ntchaps/Mono-RTP-over-UDP-Transmitter/docs/Demos/Videos/IMG_7279.JPG

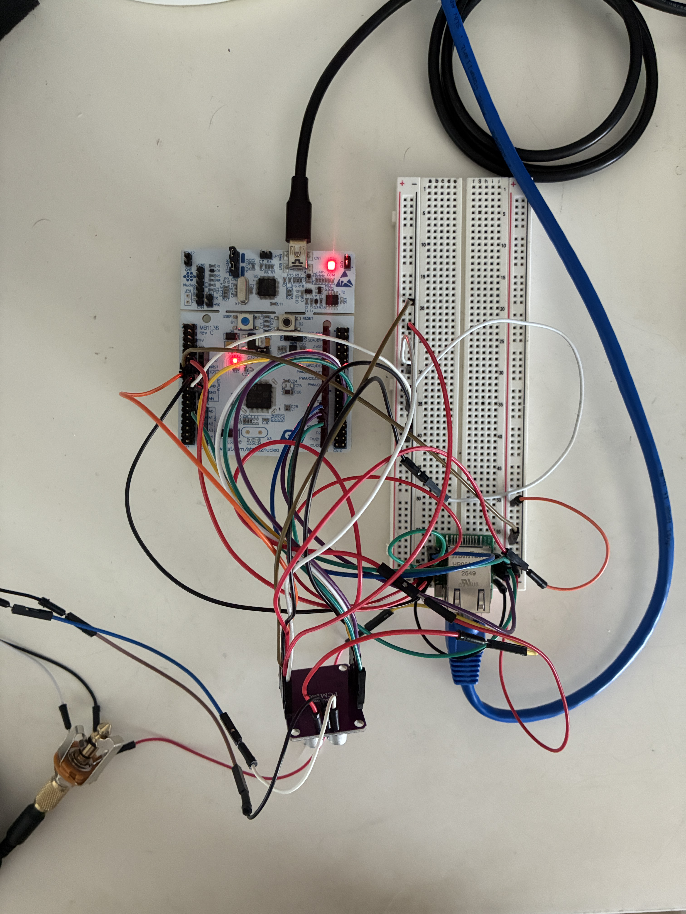
docs/Demos/Videos/IMG_7279.JPG
