ntchaps/Mono-RTP-over-UDP-Transmitter/docs/images/received_audio.png

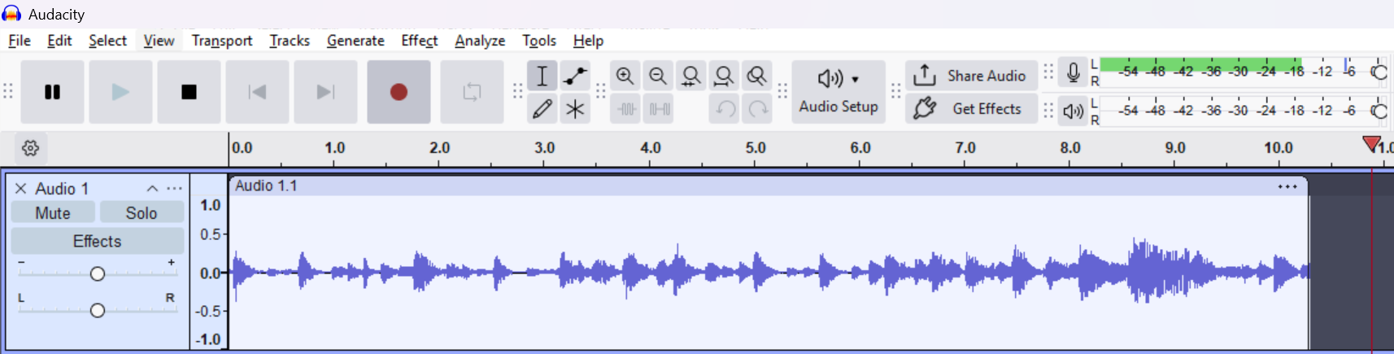
docs/images/received_audio.png
