ntchaps/Mono-RTP-over-UDP-Transmitter/docs/images/STMCubeMX_Pins.png

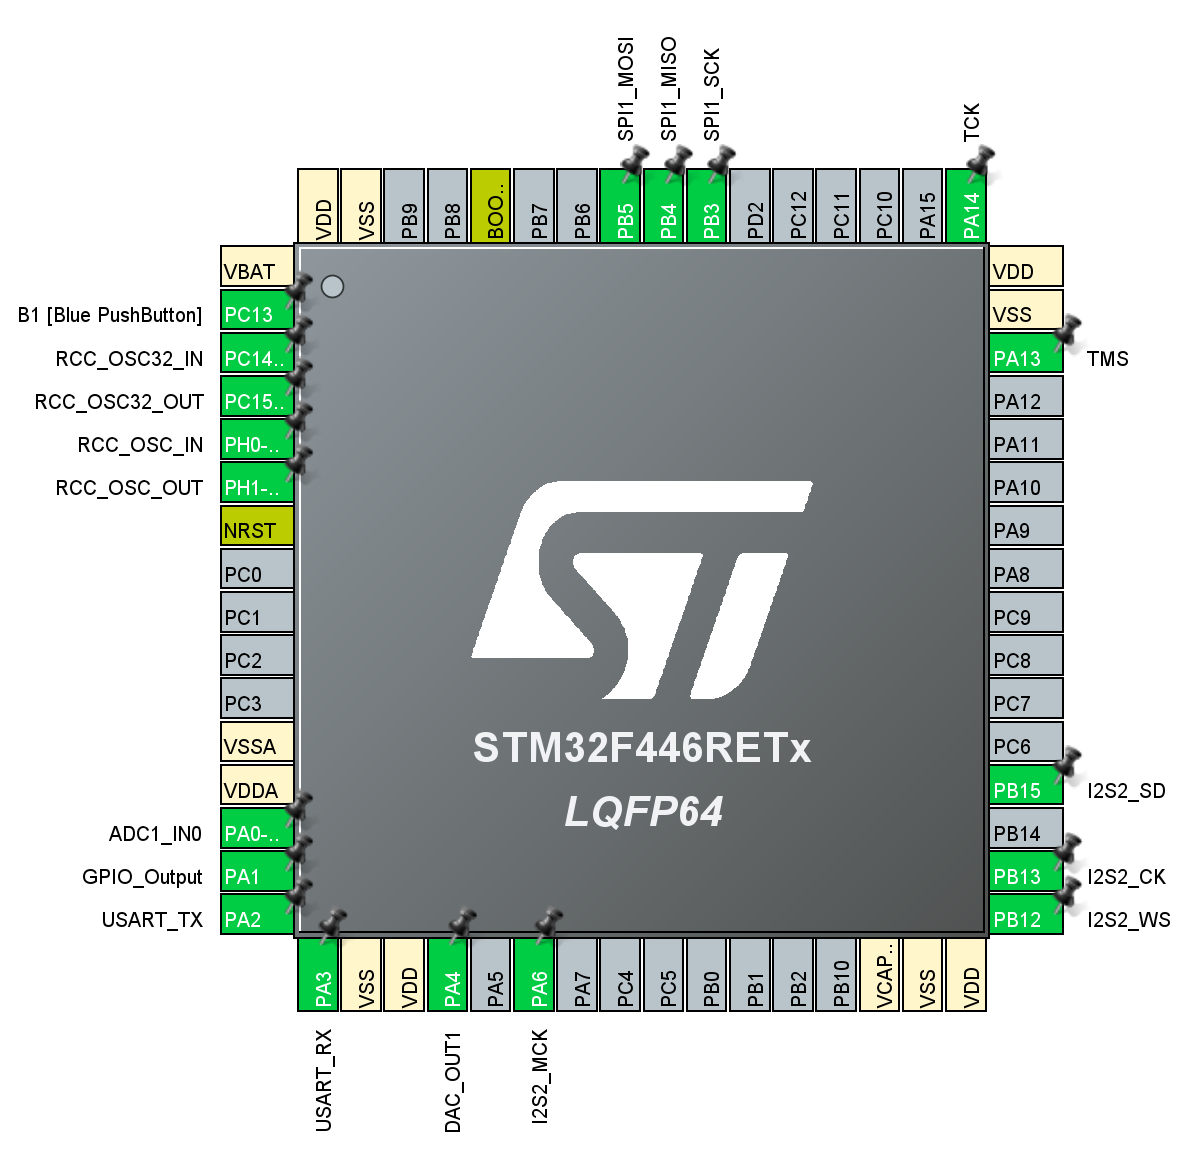
docs/images/STMCubeMX_Pins.png
