ntchaps/Mono-RTP-over-UDP-Transmitter/Mono-RTP-over-UDP-Transmitter.ioc

Mcu.UserName=STM32F446RETx
PA0-WKUP.Signal=ADCx_IN0
PA1.Signal=GPIO_Output
PA13.GPIO_Label=TMS
PA13.Signal=SYS_JTMS-SWDIO
PA14.GPIO_Label=TCK
PA14.Signal=SYS_JTCK-SWCLK
PA2.GPIO_Label=USART_TX
PA2.Signal=USART2_TX
PA3.GPIO_Label=USART_RX
PA3.Signal=USART2_RX
PA4.Signal=COMP_DAC1_group
PA6.Signal=I2S2_MCK
PB12.Signal=I2S2_WS
PB13.Signal=I2S2_CK
PB15.Signal=I2S2_SD
PB3.Signal=SPI1_SCK
PB4.Signal=SPI1_MISO
PB5.Signal=SPI1_MOSI
PC13.GPIO_Label=B1 [Blue PushButton]
PC13.Signal=GPXTI13
PC14-OSC32_IN.Signal=RCC_OSC32_IN
PC15-OSC32_OUT.Signal=RCC_OSC32_OUT
PH0-OSC_IN.Signal=RCC_OSC_IN
PH1-OSC_OUT.Signal=RCC_OSC_OUT
