ntchaps/Mono-RTP-over-UDP-Transmitter/Core/Src/audio_sine.c

/*
 * audio_sine.c
 *
 *  Created on: Jul 28, 2026
 *      Author: nickt
 */
#include "main.h"
#include "audio.h"
#include "audio_sine.h"

extern DAC_HandleTypeDef hdac;
extern TIM_HandleTypeDef htim2;

#define NS 128

/* Current position used for network PCM generation. */
static size_t network_sine_index = 0U;

// Sine look up table
static uint32_t Wave_LUT[NS] = {
    2048, 2149, 2250, 2350, 2450, 2549, 2646, 2742, 2837, 2929, 3020, 3108, 3193, 3275, 3355,
    3431, 3504, 3574, 3639, 3701, 3759, 3812, 3861, 3906, 3946, 3982, 4013, 4039, 4060, 4076,
    4087, 4094, 4095, 4091, 4082, 4069, 4050, 4026, 3998, 3965, 3927, 3884, 3837, 3786, 3730,
    3671, 3607, 3539, 3468, 3394, 3316, 3235, 3151, 3064, 2975, 2883, 2790, 2695, 2598, 2500,
    2400, 2300, 2199, 2098, 1997, 1896, 1795, 1695, 1595, 1497, 1400, 1305, 1212, 1120, 1031,
    944, 860, 779, 701, 627, 556, 488, 424, 365, 309, 258, 211, 168, 130, 97,
    69, 45, 26, 13, 4, 0, 1, 8, 19, 35, 56, 82, 113, 149, 189,
    234, 283, 336, 394, 456, 521, 591, 664, 740, 820, 902, 987, 1075, 1166, 1258,
    1353, 1449, 1546, 1645, 1745, 1845, 1946, 2047
};

void Audio_Sine_Init(void) 
{
    network_sine_index = 0U;

    // Plays Sine LUT on DAC1
    HAL_DAC_Start_DMA(&hdac, DAC_CHANNEL_1, (uint32_t*)Wave_LUT, 128, DAC_ALIGN_12B_R);
    HAL_TIM_Base_Start(&htim2);

}

void Audio_Sine_Generate(int16_t *buffer, size_t sample_count)
{
    if (buffer == NULL)
    {
        return;
    }

    for (size_t i = 0U; i < sample_count; i++)
    {
        /*
         * Wave_LUT contains unsigned 12-bit DAC values:
         *
         *     0 to 4095
         *
         * Subtracting 2048 centers the waveform around zero:
         *
         *     approximately -2048 to +2047
         *
         * Multiplying by 8 scales it into a useful signed
         * 16-bit PCM range:
         *
         *     approximately -16384 to +16376
         */
        int32_t centered_sample =
            ((int32_t)Wave_LUT[network_sine_index] - 2048) * 8;

        buffer[i] = (int16_t)centered_sample;

        network_sine_index++;

        if (network_sine_index >= NS)
        {
            network_sine_index = 0U;
        }
    }
}
