ntchaps/Mono-RTP-over-UDP-Transmitter/Core/Inc/debug_uart.h

/*
 * debug_uart.h
 *
 *  Created on: Jul 17, 2026
 *      Author: nickt
 */

#ifndef SRC_DEBUG_UART_H_
#define SRC_DEBUG_UART_H_

void Debug_Printf(const char *format, ...);


#endif /* SRC_DEBUG_UART_H_ */
