ntchaps/Mono-RTP-over-UDP-Transmitter/Core/Inc/w5500_port.h

/*
 * w5500_port.h
 *
 *  Created on: Jul 17, 2026
 *      Author: nickt
 */

#include <stdint.h>
#ifndef SRC_W5500_PORT_H_
#define SRC_W5500_PORT_H_

void W5500_Port_Init(void);

#endif /* SRC_W5500_PORT_H_ */
