ntchaps/Mono-RTP-over-UDP-Transmitter/Core/Src/network.h

/*
 * network.h
 *
 *  Created on: Jul 17, 2026
 *      Author: nickt
 */

#ifndef SRC_NETWORK_H_
#define SRC_NETWORK_H_

void Network_Init(void);
void Network_SendTestPacket(void);

#endif /* SRC_NETWORK_H_ */
