ntchaps/Mono-RTP-over-UDP-Transmitter/(commit log)

2026-06-26 Initial LED pin initilizations
2026-06-29 Sine wave LUT, DMA to DAC output working
2026-07-07 W5500 Drivers and initial UDP setup
2026-07-08 Message working from wireshark, added UART w5500 IP check.
2026-07-08 Enhance README with project details and progress
    Expanded project description, added hardware and tools sections, and detailed current progress and development plan.
2026-08-01 Receiver plays sine wave sample through PC audio output.
2026-08-05 configured pcm1808 with DMA.
2026-08-05 Audio should be sending. (Broken)
    [app.c, audio.c, audio_input.c, audio_input.h]
2026-08-06 Split calls to DMA, audio extremely buggy but passing.
    [Mono-RTP-over-UDP-Transmitter.ioc, app.c, audio_input.c, audio_input.h]
2026-08-06 Change project name to STM32-RTP-Audio-Streamer
    Updated project title and description in README.
